bontango/GottFA1_PLuS/docs/GottFA1_PLuS_user_manual.html

# GottFA1_PLuS

Gottlieb System1 MPU based on FPGA

plus: Power, Lamps, Solenoids & Sound

Hardware version v2.x

Software Version x.30

user manual

ralf@lisy.dev

v2.0 24.10.2026

German version: GottFA1_PLuS_Bedienungsanleitung.html. French version: GottFA1_PLuS_manuel_utilisateur.html. The chapter numbering is the same in all three.

## Table of contents

- Important remark
- 1. Introduction
  - 1.1. New in software x.30
- 2. Quickstart
- 3. Installation
- 4. Dip Switch Settings
  - 4.1. S1 game select
  - 4.2. S2 options
    - 4.2.1. S2-Dip1 -> Init nvram
    - 4.2.2. S2-Dip2 -> Freeplay
    - 4.2.3. S2-Dip3 -> LED displays
    - 4.2.4. S2-Dip4 -> Slam
  - 4.3. Integrated soundcard options
  - 4.4. Gottlieb DIP banks
  - 4.5. The buttons
- 5. Boot sequence
  - 5.1. Phase 1: loading the game roms
  - 5.2. Phase 2: info display
  - 5.3. Phase 3: program execution
  - 5.4. The diagnostic counters
- 6. Integrated Soundcard
  - 6.1. Background music
- 7. GottFA1 Attract Mode for System1
  - 7.1. Syntax for configuration file
  - 7.2. Converter tool attractcsv2bin.exe
- 8. Put the GottFA1 image to the SD card
- 9. Programming the FPGA
  - 9.1. Programmer software
  - 9.2. Install the driver for your USB Blaster
  - 9.3. Program your FPGA
  - 9.4. Board variants and release files
- 10. Structure of SD card
  - 10.1. Rom file structure for GottFA1
  - 10.2. Game selection
  - 10.3. Example Charlie's Angels
- 11. Game roms in the FPGA flash
- 12. Resets in the middle of a game
- Appendix A example 'Gamelist'

## Important remark

By using GottFA1 it is possible to damage your pinball machine. As this is a private project with NO commercial interest the author accepts no liability for any damage that may arise by using GottFA1!

## 1. Introduction

GottFA1_PLuS replaces almost all components of your Gottlieb System1 game. This includes:

- Main CPU board
- Power supply
- Driver board
- Soundcard

What do you need?

- Basic soldering skills
- Possibility to read/write micro SD cards (not needed if the game roms are in the FPGA flash, chapter 11)
- A PC with an USB port and an USB Blaster in order to be able to program the FPGA
- Gottlieb rom images (not included due to copyright limitation)

### 1.1. New in software x.30

- Game roms in the FPGA flash. If no SD card answers, GottFA1 reads the game roms from the flash memory the FPGA itself boots from. A board with roms in the flash runs without SD card (chapter 11).
- Reset button filtered. The 'FPGA reset' button has to be pressed for at least 50 ms. Before x.30 a single short spike on its line - typically from a coil without working flyback diode - restarted the board in the middle of a game (chapter 12).
- Slam, outhole and Gottlieb reset switch are filtered against spikes of less than 1 ms.
- Diagnostic counters on the boot display, player 4 (chapter 5.4).
- All five board variants show the same software state: 5.30, 6.30, 7.30, 8.30 and 9.30 (chapter 9.4). 5.30 is new: hardware v2.0x with the Cyclone IV board v3.

## 2. Quickstart

1. Download the latest versions of the SD card image and the FPGA program from lisy.dev - the FPGA program for your FPGA board, see chapter 9.4
2. Write the image to a SD card
3. Add Gottlieb roms
4. Program the FPGA
5. Configure switch 'game select' according to your pinball
6. Replace your original System1 MPU with GottFA1
7. Init the GottFA1 internal nvram for your game
8. Switch the game ON
9. Enjoy

## 3. Installation

GottFA1 boards have the same connectors and same mounting holes as the original Gottlieb System1 MPUs, so replacing the board can be done in seconds.

## 4. Dip Switch Settings

### 4.1. S1 game select

Here you can select what game GottFA1 should run. This depends on the roms placed on the SD card (or in the FPGA flash, chapter 11). See chapter 10 for an explanation of the structure of the SD card content and Appendix A for the arrangement on my SD card image.

### 4.2. S2 options

#### 4.2.1. S2-Dip1 -> Init nvram

With dip1 'ON' GottFA1 will initialize the nvram during boot for the selected game to zero. This is useful if you want to reset ALL ram content (recommended for the first start of the game).

#### 4.2.2. S2-Dip2 -> Freeplay

With dip2 'ON' GottFA1 will enable 'Freeplay'. By 'press and hold' the credit button for more than two seconds a coin insert for the left coin chute is simulated.

#### 4.2.3. S2-Dip3 -> LED displays

With dip3 'ON' the timing for refreshing the displays is optimized for LEDs. With the timing for the original 'tube' displays the LED displays sometimes show flickering, whereas with the 'LED' timing the 'tubes' show 'ghosting'.

#### 4.2.4. S2-Dip4 -> Slam

With dip4 'ON' GottFA1 will disable the Gottlieb slam detection (recommended).

### 4.3. Integrated soundcard options

DIP | Function
Dip1 | Sound or Tones - same as with the original soundcard
Dip2 | Attract sounds - same as with the original soundcard
Dip3 | Background music with the integrated MP3 player (chapter 6.1)

### 4.4. Gottlieb DIP banks

Here you have the same settings as with an original MPU. Consult the manual for your pinball to see how they affect the game behavior. For a 'smooth start' I recommend the following settings:

S1...S8: all OFF · S9...S16: all ON · S17...S24: DIP19 OFF, all other ON

Note: DIP16 & DIP24 are not used on the original CPU. With GottFA1 DIP16 is an option for background music (chapter 6.1) and with DIP24 you can enable attract mode (chapter 7).

### 4.5. The buttons

Button | Function
FPGA reset | Restarts GottFA1: the game roms are read again, the boot sequence starts from the beginning. Since x.30 it has to be pressed for at least 50 ms - a short tap does nothing, and neither does a spike on its line (chapter 12).
GTB_Reset | The reset switch of the original Gottlieb MPU, read by the game program.
Test | The Gottlieb test switch.
SB Test | Sound test of the integrated soundcard, as with the original Multisound board.

## 5. Boot sequence

### 5.1. Phase 1: loading the game roms

Immediately after switching on the pinball with GottFA1 inserted you will see the following output on the displays of your pinball machine:

Display | Content
Player 1 | GOTTFA
Player 2 and 3 | welcome message BY BON TANGO
Player 4 | the diagnostic counters, for example R00G00 (chapter 5.4)
Status display | setting of the soundcard options and current setting (decimal) of S1 (game number)

Meanwhile GottFA1 reads the game roms from the SD card. If no SD card answers, it reads them from the FPGA flash instead (chapter 11). With a card in the slot the card always wins.

If neither works the red LED 'SD card error' goes ON, player 4 shows ERROR, and the game does not start. With the FPGA program from lisy.dev the flash holds no roms, so without SD card that is what you will see.

### 5.2. Phase 2: info display

As soon as the roms are loaded:

Display | Content
Player 1 | GOTTFA
Player 2 | version of the FPGA program running, for example V 930 (chapter 9.4)
Player 3 | READSD - the roms came from the SD card, or READFL - the roms came from the FPGA flash
Player 4 | the diagnostic counters, or ERROR
Status display | as in phase 1

### 5.3. Phase 3: program execution

The code indicated by the Dip switch 'game select' is executed. If the code runs (regular interrupts are seen) the 'active' LED will go ON and the game takes over the displays.

### 5.4. The diagnostic counters

New with x.30. Player 4 shows two counters during boot, for example R01G37:

- R - resets that came through the 'FPGA reset' button (button pressed for at least 50 ms).
- G - short pulses on the reset line that GottFA1 ignored because they were too short to be a button press.

Both counters are only cleared when the FPGA is loaded - at power on, or when it reloads itself. A reset through the button does not clear them. They stop at 99.

So if the game restarted by itself, look at player 4 while it boots:

Player 4 after an unexpected restart | Meaning
R00G00 | The FPGA was loaded again: the supply voltage dropped, or a spike reached the configuration of the FPGA. See chapter 12.
R counted up | The reset line was low for at least 50 ms: the button was pressed, or a very strong disturbance.
G above 0 | Spikes reach the reset line and were filtered. A normal press of the button also adds a few, because the button bounces.

## 6. Integrated Soundcard

GottFA1_PLuS comes with an integrated soundcard emulation. You can choose whether you want to keep your original soundcard or use the integrated one. In case you want to use the integrated one, you need to add two wires from the GottFA speaker connector to the speaker in the cabinet.

GottFA1_PLuS can emulate the sounds of games with the Gottlieb Multisound card (games Totem and later) but as well games with the '3 tone chime board'. You can even use the 3 tone emulation for games which do have a chime board by adding a speaker to your game.

SB option switches DIP1 & 2 and the 'SB test' button have the same functionality as with the original Multisound board. With Dip1 you can choose between 'Sound' and 'Tones'. Dip2 activates attract sound (Gottlieb issues attract sounds every 8 minutes or so).

### 6.1. Background music

Dip3 of the SB options activates background music via the MP3 player. You can use a standard SD card (up to 32 GByte) and put mp3 and/or wav files of your choice on it.

Create a folder '02' (zero two) on the SD card and put all your music files in there.

GottFA1 will play the files randomly during gameplay.

With DIP16 of the Gottlieb DIP bank you can select whether the music files are started from the beginning each time you start a new game (DIP16 ON) or whether GottFA1 should remember the point in time where the music has stopped and continue at this point with the next game (DIP16 OFF).

## 7. GottFA1 Attract Mode for System1

GottFA1 supports attract mode for System1. Attract mode is activated/deactivated with Gottlieb DIP switch #24.

The attract mode actions can be self-defined in a csv configuration file which has to be converted, and the resulting '.bin' file has to be integrated in the rom on the SD card (see the example in chapter 10.3).

I have created a basic set of configuration files which can be downloaded from my repository server. Links can be found on my website https://www.lisy.dev. My SD card image already contains them for all 16 games.

### 7.1. Syntax for configuration file

During attract mode the csv file will be scanned and the commands in there will be executed. If the scan reaches the end of the configuration file it will start at the beginning again. The syntax for GottFA1 is compatible with the LISY1 syntax, with the limitation that only the commands 'lamp' and 'time' are supported.

time <wait time> <s | ms>

Wait 'wait time' in seconds or milliseconds before executing the next command. Only integer values are supported!

lamp <lamp number> <on | off>

Switch the lamp 'lamp number' (1..36) ON or OFF.

### 7.2. Converter tool attractcsv2bin.exe

You find the tool on my repository server (windows executable). It converts a csv file with attract mode commands to a bin file (fixed size 4 KByte) which can be integrated into the rom on the SD card.

Example converting 005_attract.csv to 005_attract.bin:

attractcsv2bin 005_attract

opening input file: 005_attract.csv
creating output file: 005_attract.bin
csv contained 34 commands
22 lamp commands written
12 time commands written
wrote 121 of possible 4096 bytes

## 8. Put the GottFA1 image to the SD card

On my website you will find the latest version of the GottFA1 SD card image as a (zipped) image file. After unpacking, the image can be put on a SD card. I recommend using Win32DiskImager for doing that.

This chapter uses content from the eLinux wiki page RPi_Easy_SD_Card_Setup (http://elinux.org/RPi_Easy_SD_Card_Setup), which is shared under the Creative Commons Attribution-ShareAlike 3.0 Unported license (http://creativecommons.org/licenses/by-sa/3.0/)

- Insert the SD card into your SD card reader. You can use the SD card slot if you have one, or an SD adapter in a USB port. Note the drive letter assigned to the SD card. You can see the drive letter in the left hand column of Windows Explorer, for example E:
- Download the Win32DiskImager utility from the Sourceforge Project page (http://sourceforge.net/projects/win32diskimager/) as an installer file, and run it to install the software.
- Run the Win32DiskImager utility from your desktop or menu.
- Select the GottFA1 image file you extracted earlier.
- In the device box, select the drive letter of the SD card. Be careful to select the correct drive: if you choose the wrong drive you could destroy the data on your computer's hard disk! If you are using an SD card slot in your computer, and can't see the drive in the Win32DiskImager window, try using an external SD adapter.
- Click 'Write' and wait for the write to complete.
- Exit the imager and eject the SD card.

## 9. Programming the FPGA

To program the FPGA you need the Quartus Programmer and an USB Blaster.

### 9.1. Programmer software

It can be downloaded from the Intel website for free, you just need to create a user account. In the download section of Quartus Prime Lite Edition (version 22.1 or later) go to 'Additional Software' and download Quartus Prime Programmer and Tools.

The FPGA boards of GottFA1_PLuS use a Cyclone IV or a Cyclone 10 LP. The old Quartus II 13.0sp1 does not know the Cyclone 10 LP; use a current programmer.

### 9.2. Install the driver for your USB Blaster

When connecting your USB Blaster the first time it will not be recognized correctly by Windows.

You need to install the driver for your USB Blaster. The driver comes together with the installation of the programmer and is located in its 'drivers' subdirectory.

- Right click on the entry in the device manager and choose 'update driver' (Treiber aktualisieren)
- Choose 'search for driver on this PC' (auf dem Computer nach Treibersoftware suchen)
- Select the 'drivers' folder of your programmer installation
- Confirm installation
- Now the Altera USB Blaster should be visible under 'USB-Controller'

### 9.3. Program your FPGA

1. Connect the USB Blaster to the PC

2. Start the programmer, make sure in the Hardware setup 'USB-Blaster' is visible and set the Mode to 'JTAG'

3. Select 'Add File' and choose the right 'jic' file for your FPGA board (chapter 9.4). Select the 'Program/Configure' and 'Verify' options.

4. Power the board, then connect the USB Blaster to the 'JTAG programming' connector on the GottFA1_PLuS board. Push start and wait for progress 100%. That's it!

The screenshots show an older version of the programmer; the current one looks almost the same.

### 9.4. Board variants and release files

The same design runs on several FPGA boards, and the FPGA program is not interchangeable between them - the pin assignment differs. The first digit of the version shown on player display 2 at boot tells you which program is running.

Version | Board | FPGA | Release file x.30
9.30 | HW v2.1x with Cyclone 10 board | 10CL006YE144 | HW21x_Cyclone10/GottFA1_PLuS_v930.jic
8.30 | HW v2.1x with Cyclone IV board v4 | EP4CE6E22 | HW21x_CycloneIV_v4/GottFA1_PLuS_v830.jic
7.30 | HW v2.0x with Cyclone IV board v4 | EP4CE6E22 | HW20x_CycloneIV_v4/GottFA1_PLuS_v730.jic
6.30 | HW v2.1x with Cyclone IV board v3 | EP4CE6F17 | HW21x_CycloneIV_v3/GottFA1_PLuS_v630.jic
5.30 | HW v2.0x with Cyclone IV board v3 | EP4CE6F17 | HW20x_CycloneIV_v3/GottFA1_PLuS_v530.jic

The release files have no game roms in the flash. How to build a file with roms is described in chapter 11.

Test status: 7.30 and 5.30 (both HW v2.0x) have been tested successfully on real boards. 9.30, 8.30 and 6.30 have not been tested in hardware yet; the last versions that ran on those boards are 9.01 and 8.01, a version 6.xx has never been delivered.

## 10. Structure of SD card

Due to limitations of the SD card read routine in the FPGA (it reads fixed sector numbers instead of looking for filenames) it is necessary to use my SD card image (128 MByte). You can write the image to a SD card of your choice, any size equal to or bigger than 128 MByte will work.

Note: 'Sandisk' SD cards can not be used with GottFA1!

### 10.1. Rom file structure for GottFA1

For each game GottFA1 reads a 16 KByte block from the SD card. Every block starts at sector 660 + game number x 32 and has this layout:

Offset | Size | Content
0x0000 | 2 KByte | system rom 'u5_cf.bin'
0x0800 | 2 KByte | system rom 'u4_ce.bin'
0x1000 | 1 KByte | the game specific rom, e.g. '425.cpu'
0x1400 | 1 KByte | sound rom of the Multisound games, e.g. '429.snd' - otherwise empty
0x1800 | 1 KByte | '6530sys1.bin' for the Multisound games - otherwise empty
0x1C00 | 5 KByte | gap, not used
0x3000 | 4 KByte | attract mode commands, e.g. '005_attract.bin' (chapter 7)

The gaps have to be filled, so that every block has exactly 16 KByte. There is no checksum.

### 10.2. Game selection

The first image you copy onto the SD card will be selected with game select '0' (all OFF), the second with '1' (all OFF except Dip1) and so on.

As the FPGA just reads fixed sector numbers the filename is not relevant, you can choose whatever filename you want. It just needs to be placed at the right position on the SD card. You can 'select' the position of the rom image on the SD card with the order of your file copy.

### 10.3. Example Charlie's Angels

For Charlie's Angels you need (as for all other System1 games) the two system roms 'u5_cf.bin' and 'u4_ce.bin' and the game specific rom, '425.cpu' in this case. To create a rom file for GottFA1 (charlies) including the attract mode commands you can use the following command on a windows system:

copy /b u5_cf.bin + u4_ce.bin + 425.cpu + 7K + 005_attract.bin charlies

For a Multisound game the sound roms come in between, e.g. for Totem:

copy /b u5_cf.bin + u4_ce.bin + 429.cpu + 429.snd + 6530sys1.bin + 5K + 009_attract.bin totem

The files '5K' and '7K' do not contain any data and just exist to fill the gap. They can be downloaded from my software repository on lisy.dev.

## 11. Game roms in the FPGA flash

New with software x.30. The FPGA boots from a flash chip (EPCS16, 2 MByte) on the FPGA board, and the space behind the FPGA program can hold the game roms of all 16 games. A board with roms in the flash runs without SD card.

flash address 080000h + game number x 4000h, 16 KByte per game - exactly the block of the SD card (chapter 10.1)
- With a card in the slot the card always wins. So you can still try other roms from a card without touching the flash.
- If the card is missing or does not answer, the board reads the flash. Player 3 then shows READFL instead of READSD (chapter 5.2).
- There is no checksum, neither on the card nor in the flash. GottFA1 only checks that the slot of the selected game is not empty; an empty slot shows ERROR.

The roms are copyrighted, so they cannot be part of the download from lisy.dev. You put them there yourself, from your own SD card image:

1. Build the rom file. In the GottFA1_PLuS source tree (github.com/bontango/GottFA1_PLuS) run

 scripts\make_flash_hex.ps1 -Image <image file> -Out variants\<variant>\output_files\gottfa1_roms.hex
  The script lists every game it found. Games 0 to 15 are taken, empty slots are left out.
2. Build the FPGA program of your board in the folder variants\<variant> (or take the SYS1.sof of a build) and run quartus_cpf -c gottfa1_roms.cof there. This puts the FPGA program and the roms into one file, output_files\gottfa1_roms.jic.
3. Program gottfa1_roms.jic with the Quartus Programmer instead of the normal file, with 'Verify' ticked (chapter 9.3).

The variant names are those of the source tree: hw21x_cyclone_10, hw21x_cyclone_iv_v4, hw20x_cyclone_iv_v4, hw21x_cyclone_iv_v3, hw20x_cyclone_iv_v3.

Keep that file to yourself. It contains the game roms and must not be passed on.

## 12. Resets in the middle of a game

If your game restarts by itself during play, the reason is almost always a coil whose flyback diode is missing or broken. When such a coil is switched off, it sends a voltage spike through the wiring of the machine, and this spike can reach the electronics of GottFA1.

1. Check the flyback diodes of all coils and relays (Gottlieb puts a 1N4004 directly on each coil). This is the real fix.
2. Use software x.30 or later. Up to x.03 a single spike of a few nanoseconds on the line of the 'FPGA reset' button was enough to restart the board. Since x.30 that line has to be low for 50 ms.
3. Look at the diagnostic counters after a restart (chapter 5.4). R00G00 means the FPGA was loaded again - then check the supply voltages and the coils firing at that moment.
4. On older boards a 100 nF capacitor soldered in parallel to the 'FPGA reset' button additionally keeps spikes away from that line.

The full analysis (in German) with recommendations for the hardware is in the source tree: docs/Stoerimpulse_Resets.md (https://github.com/bontango/GottFA1_PLuS/blob/main/docs/Stoerimpulse_Resets.md).

## Appendix A example 'Gamelist'

This is the arrangement on my SD card image (v2.00). Games 0 to 8 use the 3 tone sound, games 9 to 15 the Multisound board.

No | S1 | S2 | S3 | S4 | Short Name | Long Name
0 | off | off | off | off | cleoptra | Cleopatra
1 | on | off | off | off | sinbad | Sinbad
2 | off | on | off | off | jokrpokr | Joker Poker
3 | on | on | off | off | dragon | Dragon
4 | off | off | on | off | closeenc | Close Encounters of the Third Kind
5 | on | off | on | off | charlies | Charlie's Angels
6 | off | on | on | off | solaride | Solar Ride
7 | on | on | on | off | countdwn | Count-Down
8 | off | off | off | on | pinpool | Pinball Pool
9 | on | off | off | on | totem | Totem
10 | off | on | off | on | hulk | The Incredible Hulk
11 | on | on | off | on | genie | Genie
12 | off | off | on | on | buckrgrs | Buck Rogers
13 | on | off | on | on | torch | Torch
14 | off | on | on | on | roldisco | Roller Disco
15 | on | on | on | on | astannie | Asteroid Annie and the Aliens
