bontango/GottFA1_PLuS/docs/GottFA1_PLuS_Bedienungsanleitung.html

# GottFA1_PLuS

Gottlieb-System1-MPU auf FPGA-Basis

plus: Netzteil, Lampen, Spulen & Sound

Hardware-Version v2.x

Software-Version x.30

Bedienungsanleitung

ralf@lisy.dev

v2.0 24.10.2026

Deutsche Fassung von GottFA1_PLuS_user_manual.html. Version française : GottFA1_PLuS_manuel_utilisateur.html. Die Kapitelnummern sind in allen drei Fassungen gleich.

## Inhaltsverzeichnis

- Wichtiger Hinweis
- 1. Einleitung
  - 1.1. Neu in Software x.30
- 2. Schnellstart
- 3. Einbau
- 4. DIP-Schalter
  - 4.1. S1 Spielauswahl
  - 4.2. S2 Optionen
    - 4.2.1. S2-Dip1 -> NVRAM initialisieren
    - 4.2.2. S2-Dip2 -> Freispiel
    - 4.2.3. S2-Dip3 -> LED-Anzeigen
    - 4.2.4. S2-Dip4 -> Slam
  - 4.3. Optionen der integrierten Soundkarte
  - 4.4. Gottlieb-DIP-Bänke
  - 4.5. Die Taster
- 5. Startvorgang
  - 5.1. Phase 1: die Spiel-ROMs laden
  - 5.2. Phase 2: Info-Anzeige
  - 5.3. Phase 3: Programmausführung
  - 5.4. Die Diagnosezähler
- 6. Integrierte Soundkarte
  - 6.1. Hintergrundmusik
- 7. GottFA1-Attract-Mode für System1
  - 7.1. Syntax der Konfigurationsdatei
  - 7.2. Konverter attractcsv2bin.exe
- 8. Das GottFA1-Image auf die SD-Karte schreiben
- 9. Das FPGA programmieren
  - 9.1. Programmer-Software
  - 9.2. Treiber für den USB Blaster installieren
  - 9.3. Das FPGA programmieren
  - 9.4. Platinenvarianten und Release-Dateien
- 10. Aufbau der SD-Karte
  - 10.1. Aufbau einer ROM-Datei für GottFA1
  - 10.2. Spielauswahl
  - 10.3. Beispiel Charlie's Angels
- 11. Spiel-ROMs im FPGA-Flash
- 12. Resets mitten im Spiel
- Anhang A Beispiel 'Spieleliste'

## Wichtiger Hinweis

Mit GottFA1 kann man seinen Flipper beschädigen. Da es sich um ein privates Projekt OHNE kommerzielles Interesse handelt, übernimmt der Autor keinerlei Haftung für Schäden, die durch den Einsatz von GottFA1 entstehen!

## 1. Einleitung

GottFA1_PLuS ersetzt fast alle Baugruppen Ihres Gottlieb-System1-Geräts, nämlich:

- die CPU-Platine (MPU)
- das Netzteil
- die Treiberplatine
- die Soundkarte

Was Sie brauchen:

- Grundkenntnisse im Löten
- eine Möglichkeit, Micro-SD-Karten zu lesen und zu schreiben (entfällt, wenn die Spiel-ROMs im FPGA-Flash liegen, Kapitel 11)
- einen PC mit USB-Anschluss und einen USB Blaster, um das FPGA zu programmieren
- Gottlieb-ROM-Images (aus Urheberrechtsgründen nicht enthalten)

### 1.1. Neu in Software x.30

- Spiel-ROMs im FPGA-Flash. Antwortet keine SD-Karte, liest GottFA1 die Spiel-ROMs aus dem Flash-Speicher, aus dem das FPGA selbst startet. Eine Platine mit ROMs im Flash läuft ohne SD-Karte (Kapitel 11).
- Reset-Taster gefiltert. Der Taster 'FPGA reset' muss mindestens 50 ms gedrückt sein. Vor x.30 reichte ein einziger kurzer Störimpuls auf seiner Leitung - typischerweise von einer Spule ohne funktionierende Freilaufdiode -, um die Platine mitten im Spiel neu zu starten (Kapitel 12).
- Slam, Outhole und Gottlieb-Reset-Schalter sind gegen Störimpulse unter 1 ms gefiltert.
- Diagnosezähler auf der Startanzeige, Spieler 4 (Kapitel 5.4).
- Alle fünf Platinenvarianten haben denselben Softwarestand: 5.30, 6.30, 7.30, 8.30 und 9.30 (Kapitel 9.4). Neu ist 5.30: Hardware v2.0x mit der Cyclone-IV-Platine v3.

## 2. Schnellstart

1. Die aktuellen Versionen des SD-Karten-Images und des FPGA-Programms von lisy.dev herunterladen - das FPGA-Programm für Ihre FPGA-Platine, siehe Kapitel 9.4
2. Das Image auf eine SD-Karte schreiben
3. Die Gottlieb-ROMs hinzufügen
4. Das FPGA programmieren
5. Den Schalter 'Spielauswahl' passend zu Ihrem Flipper einstellen
6. Die originale System1-MPU durch GottFA1 ersetzen
7. Das interne NVRAM von GottFA1 für Ihr Spiel initialisieren
8. Den Flipper einschalten
9. Spielen

## 3. Einbau

GottFA1-Platinen haben dieselben Steckverbinder und dieselben Befestigungslöcher wie die originalen Gottlieb-System1-MPUs. Der Tausch ist in Sekunden erledigt.

## 4. DIP-Schalter

### 4.1. S1 Spielauswahl

Hier wählen Sie, welches Spiel GottFA1 ausführt. Das hängt davon ab, welche ROMs auf der SD-Karte (oder im FPGA-Flash, Kapitel 11) liegen. Kapitel 10 erklärt den Aufbau der SD-Karte, Anhang A zeigt die Belegung meines SD-Karten-Images.

### 4.2. S2 Optionen

#### 4.2.1. S2-Dip1 -> NVRAM initialisieren

Mit Dip1 auf 'ON' setzt GottFA1 beim Start das NVRAM des gewählten Spiels auf null. Das ist nützlich, wenn Sie den GESAMTEN RAM-Inhalt zurücksetzen wollen (empfohlen beim ersten Start des Spiels).

#### 4.2.2. S2-Dip2 -> Freispiel

Mit Dip2 auf 'ON' schaltet GottFA1 das Freispiel ein. Wird der Credit-Knopf länger als zwei Sekunden gedrückt gehalten, simuliert GottFA1 einen Münzeinwurf im linken Münzprüfer.

#### 4.2.3. S2-Dip3 -> LED-Anzeigen

Mit Dip3 auf 'ON' ist das Timing für die Auffrischung der Anzeigen auf LEDs optimiert. Mit dem Timing für die originalen Röhrenanzeigen flackern LED-Anzeigen manchmal, mit dem LED-Timing zeigen die Röhren dagegen 'Geisterbilder'.

#### 4.2.4. S2-Dip4 -> Slam

Mit Dip4 auf 'ON' schaltet GottFA1 die Slam-Erkennung von Gottlieb ab (empfohlen).

### 4.3. Optionen der integrierten Soundkarte

DIP | Funktion
Dip1 | Sound oder Töne - wie bei der originalen Soundkarte
Dip2 | Attract-Sounds - wie bei der originalen Soundkarte
Dip3 | Hintergrundmusik über den integrierten MP3-Player (Kapitel 6.1)

### 4.4. Gottlieb-DIP-Bänke

Hier haben Sie dieselben Einstellungen wie bei einer originalen MPU. Wie sie sich auf das Spiel auswirken, steht im Handbuch Ihres Flippers. Für einen 'sanften Start' empfehle ich:

S1...S8: alle OFF · S9...S16: alle ON · S17...S24: DIP19 OFF, alle anderen ON

Hinweis: DIP16 und DIP24 werden auf der originalen CPU nicht benutzt. Bei GottFA1 ist DIP16 eine Option für die Hintergrundmusik (Kapitel 6.1), mit DIP24 schalten Sie den Attract-Mode ein (Kapitel 7).

### 4.5. Die Taster

Taster | Funktion
FPGA reset | Startet GottFA1 neu: die Spiel-ROMs werden neu gelesen, der Startvorgang beginnt von vorn. Seit x.30 muss er mindestens 50 ms gedrückt sein - kurzes Antippen bewirkt nichts, ein Störimpuls auf seiner Leitung ebenso wenig (Kapitel 12).
GTB_Reset | Der Reset-Schalter der originalen Gottlieb-MPU, wird vom Spielprogramm gelesen.
Test | Der Gottlieb-Testschalter.
SB Test | Soundtest der integrierten Soundkarte, wie bei der originalen Multisound-Karte.

## 5. Startvorgang

### 5.1. Phase 1: die Spiel-ROMs laden

Direkt nach dem Einschalten des Flippers mit eingesetztem GottFA1 sehen Sie auf den Anzeigen:

Anzeige | Inhalt
Spieler 1 | GOTTFA
Spieler 2 und 3 | Begrüßung BY BON TANGO
Spieler 4 | die Diagnosezähler, zum Beispiel R00G00 (Kapitel 5.4)
Statusanzeige | Einstellung der Soundkarten-Optionen und aktuelle Einstellung (dezimal) von S1 (Spielnummer)

Währenddessen liest GottFA1 die Spiel-ROMs von der SD-Karte. Antwortet keine SD-Karte, liest es sie stattdessen aus dem FPGA-Flash (Kapitel 11). Steckt eine Karte, hat die Karte immer Vorrang.

Klappt beides nicht, geht die rote LED 'SD card error' an, Spieler 4 zeigt ERROR, und das Spiel startet nicht. Mit dem FPGA-Programm von lisy.dev enthält der Flash keine ROMs - ohne SD-Karte sehen Sie also genau das.

### 5.2. Phase 2: Info-Anzeige

Sobald die ROMs geladen sind:

Anzeige | Inhalt
Spieler 1 | GOTTFA
Spieler 2 | Version des laufenden FPGA-Programms, zum Beispiel V 930 (Kapitel 9.4)
Spieler 3 | READSD - die ROMs kamen von der SD-Karte, oder READFL - die ROMs kamen aus dem FPGA-Flash
Spieler 4 | die Diagnosezähler oder ERROR
Statusanzeige | wie in Phase 1

### 5.3. Phase 3: Programmausführung

Der mit dem DIP-Schalter 'Spielauswahl' gewählte Code wird ausgeführt. Läuft der Code (regelmäßige Interrupts), geht die LED 'active' an und das Spiel übernimmt die Anzeigen.

### 5.4. Die Diagnosezähler

Neu mit x.30. Spieler 4 zeigt beim Start zwei Zähler, zum Beispiel R01G37:

- R - Resets, die über den Taster 'FPGA reset' kamen (Taster mindestens 50 ms gedrückt).
- G - kurze Impulse auf der Reset-Leitung, die GottFA1 ignoriert hat, weil sie für einen Tastendruck zu kurz waren.

Beide Zähler werden nur gelöscht, wenn das FPGA geladen wird - beim Einschalten oder wenn es sich selbst neu lädt. Ein Reset über den Taster löscht sie nicht. Sie bleiben bei 99 stehen.

Ist das Spiel also von selbst neu gestartet, schauen Sie beim Start auf Spieler 4:

Spieler 4 nach einem unerwarteten Neustart | Bedeutung
R00G00 | Das FPGA wurde neu geladen: die Versorgungsspannung ist eingebrochen, oder ein Störimpuls hat die Konfiguration des FPGA erreicht. Siehe Kapitel 12.
R hochgezählt | Die Reset-Leitung war mindestens 50 ms low: der Taster wurde gedrückt, oder eine sehr starke Störung.
G über 0 | Störimpulse erreichen die Reset-Leitung und wurden ausgefiltert. Auch ein normaler Tastendruck zählt ein paar dazu, weil der Taster prellt.

## 6. Integrierte Soundkarte

GottFA1_PLuS hat eine integrierte Soundkarten-Emulation. Sie können Ihre originale Soundkarte behalten oder die integrierte benutzen. Für die integrierte brauchen Sie zwei Leitungen vom Lautsprecheranschluss der GottFA-Platine zum Lautsprecher im Gehäuse.

GottFA1_PLuS emuliert die Sounds der Spiele mit der Gottlieb-Multisound-Karte (Totem und später), aber auch die der Spiele mit der '3-Ton-Glockenplatine'. Die 3-Ton-Emulation können Sie sogar bei Spielen mit Glockenplatine verwenden, wenn Sie einen Lautsprecher einbauen.

Die SB-Optionsschalter DIP1 und 2 und der Taster 'SB test' funktionieren wie auf der originalen Multisound-Karte. Mit Dip1 wählen Sie zwischen 'Sound' und 'Tönen'. Dip2 schaltet die Attract-Sounds ein (Gottlieb spielt etwa alle 8 Minuten einen Attract-Sound).

### 6.1. Hintergrundmusik

Dip3 der SB-Optionen schaltet die Hintergrundmusik über den MP3-Player ein. Sie können eine normale SD-Karte (bis 32 GByte) verwenden und mp3- und/oder wav-Dateien Ihrer Wahl darauf ablegen.

Legen Sie auf der SD-Karte einen Ordner '02' (null zwei) an und kopieren Sie alle Musikdateien dort hinein.

GottFA1 spielt die Dateien während des Spiels in zufälliger Reihenfolge.

Mit DIP16 der Gottlieb-DIP-Bank wählen Sie, ob die Musik bei jedem neuen Spiel von vorn beginnt (DIP16 ON) oder ob GottFA1 sich die Stelle merkt, an der die Musik aufgehört hat, und im nächsten Spiel dort weiterspielt (DIP16 OFF).

## 7. GottFA1-Attract-Mode für System1

GottFA1 unterstützt einen Attract-Mode für System1. Der Attract-Mode wird mit dem Gottlieb-DIP-Schalter #24 ein- und ausgeschaltet.

Die Abläufe des Attract-Mode lassen sich selbst in einer csv-Konfigurationsdatei festlegen. Diese wird umgewandelt, und die entstehende '.bin'-Datei wird in das ROM auf der SD-Karte eingebaut (siehe Beispiel in Kapitel 10.3).

Einen Grundstock an Konfigurationsdateien gibt es auf meinem Repository-Server, die Links stehen auf meiner Website https://www.lisy.dev. Mein SD-Karten-Image enthält sie bereits für alle 16 Spiele.

### 7.1. Syntax der Konfigurationsdatei

Im Attract-Mode wird die csv-Datei durchlaufen und die Befehle darin werden ausgeführt. Am Ende der Datei beginnt der Durchlauf wieder von vorn. Die Syntax ist zu LISY1 kompatibel, mit der Einschränkung, dass nur die Befehle 'lamp' und 'time' unterstützt werden.

time <wait time> <s | ms>

Wartet 'wait time' Sekunden oder Millisekunden, bevor der nächste Befehl ausgeführt wird. Nur ganze Zahlen!

lamp <lamp number> <on | off>

Schaltet die Lampe 'lamp number' (1..36) ein (ON) oder aus (OFF).

### 7.2. Konverter attractcsv2bin.exe

Das Programm (Windows) finden Sie auf meinem Repository-Server. Es wandelt eine csv-Datei mit Attract-Mode-Befehlen in eine bin-Datei (feste Größe 4 KByte) um, die in das ROM auf der SD-Karte eingebaut werden kann.

Beispiel: 005_attract.csv in 005_attract.bin umwandeln:

attractcsv2bin 005_attract

opening input file: 005_attract.csv
creating output file: 005_attract.bin
csv contained 34 commands
22 lamp commands written
12 time commands written
wrote 121 of possible 4096 bytes

## 8. Das GottFA1-Image auf die SD-Karte schreiben

Auf meiner Website finden Sie die aktuelle Version des GottFA1-SD-Karten-Images als (gezippte) Image-Datei. Nach dem Entpacken kann das Image auf eine SD-Karte geschrieben werden. Ich empfehle dafür Win32DiskImager.

Dieses Kapitel verwendet Inhalte der eLinux-Wiki-Seite RPi_Easy_SD_Card_Setup (http://elinux.org/RPi_Easy_SD_Card_Setup), veröffentlicht unter der Creative Commons Attribution-ShareAlike 3.0 Unported license (http://creativecommons.org/licenses/by-sa/3.0/)

- Stecken Sie die SD-Karte in Ihr Kartenlesegerät - den eingebauten Kartenschlitz, falls vorhanden, oder einen SD-Adapter am USB-Anschluss. Merken Sie sich den Laufwerksbuchstaben der SD-Karte. Sie sehen ihn in der linken Spalte des Windows-Explorers, zum Beispiel E:
- Laden Sie Win32DiskImager als Installationsdatei von der Sourceforge-Projektseite (http://sourceforge.net/projects/win32diskimager/) herunter und installieren Sie das Programm.
- Starten Sie Win32DiskImager über den Desktop oder das Startmenü.
- Wählen Sie die zuvor entpackte GottFA1-Image-Datei aus.
- Wählen Sie im Feld 'Device' den Laufwerksbuchstaben der SD-Karte. Achten Sie auf das richtige Laufwerk: wählen Sie ein falsches, können Sie die Daten auf der Festplatte Ihres Computers zerstören! Sehen Sie bei einem eingebauten Kartenschlitz das Laufwerk im Fenster von Win32DiskImager nicht, versuchen Sie es mit einem externen SD-Adapter.
- Klicken Sie auf 'Write' und warten Sie, bis der Schreibvorgang abgeschlossen ist.
- Beenden Sie das Programm und werfen Sie die SD-Karte aus.

## 9. Das FPGA programmieren

Zum Programmieren des FPGA brauchen Sie den Quartus Programmer und einen USB Blaster.

### 9.1. Programmer-Software

Sie können ihn kostenlos von der Intel-Website herunterladen, Sie brauchen nur ein Benutzerkonto. Im Download-Bereich der Quartus Prime Lite Edition (Version 22.1 oder neuer) unter 'Additional Software' laden Sie Quartus Prime Programmer and Tools herunter.

Die FPGA-Platinen von GottFA1_PLuS tragen einen Cyclone IV oder einen Cyclone 10 LP. Das alte Quartus II 13.0sp1 kennt den Cyclone 10 LP nicht; verwenden Sie einen aktuellen Programmer.

### 9.2. Treiber für den USB Blaster installieren

Wenn Sie den USB Blaster zum ersten Mal anschließen, erkennt Windows ihn nicht richtig.

Sie müssen den Treiber für den USB Blaster installieren. Er wird zusammen mit dem Programmer installiert und liegt dort im Unterordner 'drivers'.

- Rechtsklick auf den Eintrag im Geräte-Manager, 'Treiber aktualisieren' wählen
- 'Auf dem Computer nach Treibersoftware suchen' wählen
- Den Ordner 'drivers' Ihrer Programmer-Installation auswählen
- Installation bestätigen
- Jetzt sollte der Altera USB Blaster unter 'USB-Controller' zu sehen sein

### 9.3. Das FPGA programmieren

1. Den USB Blaster mit dem PC verbinden

2. Den Programmer starten, unter 'Hardware Setup' prüfen, dass 'USB-Blaster' zu sehen ist, und den Modus auf 'JTAG' stellen

3. 'Add File' wählen und die richtige 'jic'-Datei für Ihre FPGA-Platine auswählen (Kapitel 9.4). Die Optionen 'Program/Configure' und 'Verify' ankreuzen.

4. Die Platine mit Strom versorgen und den USB Blaster an den Stecker 'JTAG programming' auf der GottFA1_PLuS-Platine anschließen. 'Start' drücken und warten, bis der Fortschritt 100 % erreicht. Fertig!

Die Bildschirmfotos zeigen eine ältere Version des Programmers; die aktuelle sieht fast genauso aus.

### 9.4. Platinenvarianten und Release-Dateien

Dasselbe Design läuft auf mehreren FPGA-Platinen, und das FPGA-Programm ist zwischen ihnen nicht austauschbar - die Pinbelegung ist verschieden. An der ersten Ziffer der Version, die beim Start auf Spieler 2 erscheint, erkennen Sie, welches Programm läuft.

Version | Platine | FPGA | Release-Datei x.30
9.30 | HW v2.1x mit Cyclone-10-Platine | 10CL006YE144 | HW21x_Cyclone10/GottFA1_PLuS_v930.jic
8.30 | HW v2.1x mit Cyclone-IV-Platine v4 | EP4CE6E22 | HW21x_CycloneIV_v4/GottFA1_PLuS_v830.jic
7.30 | HW v2.0x mit Cyclone-IV-Platine v4 | EP4CE6E22 | HW20x_CycloneIV_v4/GottFA1_PLuS_v730.jic
6.30 | HW v2.1x mit Cyclone-IV-Platine v3 | EP4CE6F17 | HW21x_CycloneIV_v3/GottFA1_PLuS_v630.jic
5.30 | HW v2.0x mit Cyclone-IV-Platine v3 | EP4CE6F17 | HW20x_CycloneIV_v3/GottFA1_PLuS_v530.jic

Die Release-Dateien enthalten keine Spiel-ROMs im Flash. Wie Sie eine Datei mit ROMs bauen, beschreibt Kapitel 11.

Teststand: 7.30 und 5.30 (beide HW v2.0x) sind auf echten Platinen erfolgreich getestet. 9.30, 8.30 und 6.30 sind noch nicht in Hardware getestet; zuletzt liefen auf diesen Platinen 9.01 und 8.01, eine Version 6.xx wurde nie ausgeliefert.

## 10. Aufbau der SD-Karte

Weil die Leseroutine für die SD-Karte im FPGA feste Sektornummern liest, statt nach Dateinamen zu suchen, brauchen Sie mein SD-Karten-Image (128 MByte). Sie können es auf eine beliebige SD-Karte mit mindestens 128 MByte schreiben.

Hinweis: SD-Karten von 'Sandisk' funktionieren mit GottFA1 nicht!

### 10.1. Aufbau einer ROM-Datei für GottFA1

Für jedes Spiel liest GottFA1 einen Block von 16 KByte von der SD-Karte. Jeder Block beginnt bei Sektor 660 + Spielnummer x 32 und ist so aufgebaut:

Offset | Größe | Inhalt
0x0000 | 2 KByte | System-ROM 'u5_cf.bin'
0x0800 | 2 KByte | System-ROM 'u4_ce.bin'
0x1000 | 1 KByte | das spielspezifische ROM, z. B. '425.cpu'
0x1400 | 1 KByte | Sound-ROM der Multisound-Spiele, z. B. '429.snd' - sonst leer
0x1800 | 1 KByte | '6530sys1.bin' für die Multisound-Spiele - sonst leer
0x1C00 | 5 KByte | Lücke, nicht benutzt
0x3000 | 4 KByte | Attract-Mode-Befehle, z. B. '005_attract.bin' (Kapitel 7)

Die Lücken müssen aufgefüllt werden, damit jeder Block genau 16 KByte groß ist. Eine Prüfsumme gibt es nicht.

### 10.2. Spielauswahl

Das erste Image, das Sie auf die SD-Karte kopieren, wird mit Spielauswahl '0' (alle OFF) gewählt, das zweite mit '1' (alle OFF außer Dip1) und so weiter.

Da das FPGA nur feste Sektornummern liest, spielt der Dateiname keine Rolle - Sie können ihn frei wählen. Die Datei muss nur an der richtigen Stelle auf der SD-Karte liegen, und diese Stelle bestimmen Sie über die Reihenfolge, in der Sie die Dateien kopieren.

### 10.3. Beispiel Charlie's Angels

Für Charlie's Angels brauchen Sie (wie für alle anderen System1-Spiele) die beiden System-ROMs 'u5_cf.bin' und 'u4_ce.bin' und das spielspezifische ROM, hier '425.cpu'. Eine ROM-Datei für GottFA1 (charlies) mit Attract-Mode-Befehlen erzeugen Sie unter Windows mit:

copy /b u5_cf.bin + u4_ce.bin + 425.cpu + 7K + 005_attract.bin charlies

Bei einem Multisound-Spiel kommen die Sound-ROMs dazwischen, z. B. bei Totem:

copy /b u5_cf.bin + u4_ce.bin + 429.cpu + 429.snd + 6530sys1.bin + 5K + 009_attract.bin totem

Die Dateien '5K' und '7K' enthalten keine Daten und füllen nur die Lücke. Sie liegen in meinem Software-Repository auf lisy.dev.

## 11. Spiel-ROMs im FPGA-Flash

Neu mit Software x.30. Das FPGA startet aus einem Flash-Baustein (EPCS16, 2 MByte) auf der FPGA-Platine, und der Platz hinter dem FPGA-Programm reicht für die Spiel-ROMs aller 16 Spiele. Eine Platine mit ROMs im Flash läuft ohne SD-Karte.

Flash-Adresse 080000h + Spielnummer x 4000h, 16 KByte je Spiel - genau der Block der SD-Karte (Kapitel 10.1)
- Steckt eine Karte, hat die Karte immer Vorrang. So können Sie andere ROMs von einer Karte ausprobieren, ohne den Flash anzufassen.
- Fehlt die Karte oder antwortet sie nicht, liest die Platine den Flash. Spieler 3 zeigt dann READFL statt READSD (Kapitel 5.2).
- Eine Prüfsumme gibt es weder auf der Karte noch im Flash. GottFA1 prüft nur, dass der Platz des gewählten Spiels nicht leer ist; ein leerer Platz zeigt ERROR.

Die ROMs sind urheberrechtlich geschützt und können deshalb nicht Teil des Downloads von lisy.dev sein. Sie bringen sie selbst dorthin, aus Ihrem eigenen SD-Karten-Image:

1. Die ROM-Datei bauen. Im GottFA1_PLuS-Quellbaum (github.com/bontango/GottFA1_PLuS) aufrufen:

 scripts\make_flash_hex.ps1 -Image <image file> -Out variants\<variant>\output_files\gottfa1_roms.hex
  Das Skript listet jedes gefundene Spiel auf. Übernommen werden die Spiele 0 bis 15, leere Plätze werden ausgelassen.
2. Das FPGA-Programm Ihrer Platine im Ordner variants\<variant> bauen (oder die SYS1.sof eines Builds nehmen) und dort quartus_cpf -c gottfa1_roms.cof aufrufen. Das packt FPGA-Programm und ROMs in eine Datei, output_files\gottfa1_roms.jic.
3. gottfa1_roms.jic statt der normalen Datei mit dem Quartus Programmer programmieren, mit angekreuztem 'Verify' (Kapitel 9.3).

Die Variantennamen sind die des Quellbaums: hw21x_cyclone_10, hw21x_cyclone_iv_v4, hw20x_cyclone_iv_v4, hw21x_cyclone_iv_v3, hw20x_cyclone_iv_v3.

Behalten Sie diese Datei für sich. Sie enthält die Spiel-ROMs und darf nicht weitergegeben werden.

## 12. Resets mitten im Spiel

Startet Ihr Spiel während des Spielens von selbst neu, ist die Ursache fast immer eine Spule mit fehlender oder defekter Freilaufdiode. Schaltet eine solche Spule ab, schickt sie eine Spannungsspitze durch die Verkabelung des Geräts, und diese Spitze kann die Elektronik von GottFA1 erreichen.

1. Prüfen Sie die Freilaufdioden aller Spulen und Relais (Gottlieb setzt eine 1N4004 direkt an jede Spule). Das ist die eigentliche Abhilfe.
2. Verwenden Sie Software x.30 oder neuer. Bis x.03 reichte ein einziger Störimpuls von wenigen Nanosekunden auf der Leitung des Tasters 'FPGA reset', um die Platine neu zu starten. Seit x.30 muss diese Leitung 50 ms low sein.
3. Schauen Sie nach einem Neustart auf die Diagnosezähler (Kapitel 5.4). R00G00 bedeutet, dass das FPGA neu geladen wurde - dann die Versorgungsspannungen prüfen und die Spulen, die in diesem Moment geschaltet haben.
4. Bei älteren Platinen hält ein 100-nF-Kondensator, parallel zum Taster 'FPGA reset' eingelötet, Störimpulse zusätzlich von dieser Leitung fern.

Die vollständige Auswertung mit Empfehlungen für die Hardware steht im Quellbaum: docs/Stoerimpulse_Resets.md (https://github.com/bontango/GottFA1_PLuS/blob/main/docs/Stoerimpulse_Resets.md).

## Anhang A Beispiel 'Spieleliste'

Das ist die Belegung meines SD-Karten-Images (v2.00). Spiele 0 bis 8 benutzen den 3-Ton-Sound, Spiele 9 bis 15 die Multisound-Karte. Spielnamen, Kurznamen und on/off stehen unverändert wie im Original.

Nr | S1 | S2 | S3 | S4 | Kurzname | Name
0 | off | off | off | off | cleoptra | Cleopatra
1 | on | off | off | off | sinbad | Sinbad
2 | off | on | off | off | jokrpokr | Joker Poker
3 | on | on | off | off | dragon | Dragon
4 | off | off | on | off | closeenc | Close Encounters of the Third Kind
5 | on | off | on | off | charlies | Charlie's Angels
6 | off | on | on | off | solaride | Solar Ride
7 | on | on | on | off | countdwn | Count-Down
8 | off | off | off | on | pinpool | Pinball Pool
9 | on | off | off | on | totem | Totem
10 | off | on | off | on | hulk | The Incredible Hulk
11 | on | on | off | on | genie | Genie
12 | off | off | on | on | buckrgrs | Buck Rogers
13 | on | off | on | on | torch | Torch
14 | off | on | on | on | roldisco | Roller Disco
15 | on | on | on | on | astannie | Asteroid Annie and the Aliens
