bontango/GottFA1_PLuS/bin/changelog.txt

GottFA1_PLuS - ausgelieferte Programmierdateien
===============================================

Ab dem Umbau auf den gemeinsamen Sourcebaum (13.08.2026) legt scripts\release.ps1
die Artefakte nach bin\<BinFolder>\GottFA1_PLuS_v<BoardId><SW_SUB>.jic und haengt
unten an diese Datei an. Der Dateiname traegt die Version, der Ordner das Board.

Die vier Dateien, die schon vorher hier lagen, folgen einer aelteren Namensgebung
(flach in bin\, Platine statt Board im Namen). Ihre Zuordnung - nachtraeglich
bestimmt, weil sie aus dem Namen allein NICHT hervorgeht:

  GottFA1_PLuS_HW20x_v700.jic   2.097.375 B  Cyclone IV  hw20x_cyclone_iv_v4   Code 7.00
  GottFA1_PLuS_HW20x_v701.jic   2.097.375 B  Cyclone IV  hw20x_cyclone_iv_v4   Code 7.01
  GottFA1_PLuS_HW21x_v801.jic   2.097.375 B  Cyclone IV  hw21x_cyclone_iv_v4   Code 8.01
  GottFA1_PLuS_HW21x_v901.jic   2.097.377 B  Cyclone 10  hw21x_cyclone_10      Code 9.01

Der Nachweis fuer die letzte Zeile ist die Dateigroesse: 2.097.377 Byte ist
geraetetypisch fuer 10CL006Y, waehrend EP4CE6 2.097.375 Byte liefert. Das ist
wichtig, weil die Variante hw21x_cyclone_iv_v3 vor dem Umbau ebenfalls "V 901"
anzeigte, obwohl sie nur den Code-Stand 8.01 hatte - von IHR wurde nie etwas
ausgeliefert. Sie hat deshalb jetzt die Board-ID 6.

Board-IDs: 6 = HW v2.1x Cyclone IV v3 (EP4CE6F17C8, 256-FBGA)
           7 = HW v2.0x Cyclone IV v4 (EP4CE6E22C8)
           8 = HW v2.1x Cyclone IV v4 (EP4CE6E22C8)
           9 = HW v2.1x Cyclone 10    (10CL006YE144C8G)

Welches Board mit welchem Stand tatsaechlich auf Hardware lief, steht in
VARIANTEN.md - nicht hier.

2026-10-24 12:28  Version .30
  x.30: game ROMs from the configuration flash (EPCS16) when no SD card answers, no CRC; reset button filtered (50 ms), slam/outhole/reset switch filtered (1 ms); diagnostic counters R/G on the boot display. Not hardware tested.
  hw20x_cyclone_iv_v4    7.30   GottFA1_PLuS_v730.jic         2.097.375 B  sha256:100EFB2996800F17
  hw21x_cyclone_10       9.30   GottFA1_PLuS_v930.jic         2.097.377 B  sha256:ED793AEE1122F60C
  hw21x_cyclone_iv_v3    6.30   GottFA1_PLuS_v630.jic         2.097.375 B  sha256:9094A86522BAB6E8
  hw21x_cyclone_iv_v4    8.30   GottFA1_PLuS_v830.jic         2.097.375 B  sha256:BE102ACA494F3166

  Details x.30 (all boards, display V 630 / V 730 / V 830 / V 930):
  - Game ROMs from the FPGA configuration flash (EPCS16): when no SD card answers, the
    same 16 KByte per game are read from flash address 080000h + game * 4000h
    (rtl/common/Flash_ROM.vhd). No CRC check, only a check against an empty slot
    (first byte FF -> ERROR). Boot from flash shows READFL instead of READSD.
  - Reset button: has to be low for 50 ms (rtl/common/input_filter.vhd). Before, a
    single 20 ns spike on the pin restarted the board - the most likely cause of the
    "reset in the middle of a game" reports (coils without flyback diode).
  - Slam, outhole and Gottlieb reset switch: 1 ms glitch filter.
  - Diagnostic counters on the boot display, player 4: "R01G37" = resets through the
    reset button / dropped short pulses on it. Cleared only at power-up, so R00G00
    after an unexpected restart means the FPGA was reconfigured (supply dip, nCONFIG).
  - MISO with weak pull-up.
  - Background and hardware recommendations: docs/Stoerimpulse_Resets.md.
  Without game ROMs (flash fallback empty, needs an SD card as before): the four files above.
  WITH game ROMs from GottFA1_SD_Image_v200.img, games 0..15 - local use only, not on
  GitHub (copyrighted ROMs, *_roms.jic in .gitignore):
  hw20x_cyclone_iv_v4    7.30   GottFA1_PLuS_v730_roms.jic    2.097.375 B  sha256:AC908DB176281E58
  hw21x_cyclone_10       9.30   GottFA1_PLuS_v930_roms.jic    2.097.377 B  sha256:F1C923D94E986DBC
  hw21x_cyclone_iv_v3    6.30   GottFA1_PLuS_v630_roms.jic    2.097.375 B  sha256:64AAB9E1ADBA9C15
  hw21x_cyclone_iv_v4    8.30   GottFA1_PLuS_v830_roms.jic    2.097.375 B  sha256:5F10B728DDF67693

2026-10-24  7.30 (hw20x_cyclone_iv_v4) tested successfully on hardware. 9.30, 8.30 and 6.30 not hardware tested yet.

2026-10-24 16:02  Version .30
  New variant hw20x_cyclone_iv_v3: hardware v2.0x with the Cyclone IV board v3 (EP4CE6F17C8), board id 5, same x.30 code as all other boards. Pinout translated from hw20x_cyclone_iv_v4 via the header pinout of the two FPGA boards. Not hardware tested.
  hw20x_cyclone_iv_v3    5.30   GottFA1_PLuS_v530.jic         2.097.375 B  sha256:00E5430F6672877F
  WITH game ROMs from GottFA1_SD_Image_v200.img (local use only, *_roms.jic in .gitignore):
  hw20x_cyclone_iv_v3    5.30   GottFA1_PLuS_v530_roms.jic    2.097.375 B  sha256:2F1025FB83003BBF

2026-10-24  5.30 (hw20x_cyclone_iv_v3) tested successfully on hardware. Tested so far: 7.30 and 5.30; 9.30, 8.30 and 6.30 not yet.

2026-10-24 19:36  Version .30
  Erstes Release fuer das Cyclone-IV-Board v7 (V 430): FA-Control ueber den ESP32-C3 auf X7, PPS4-RAM im M9K. Auf v7 getestet: Boot von SD und ohne SD (READFL, ROMs ueber WLAN geschrieben), FA-Control-Connect, Displays. Lampen/Spulen/Schalter/Sound unter FA-Control ungetestet.
  hw20x_cyclone_iv_v7    4.30   GottFA1_PLuS_v430.jic         2.097.375 B  sha256:A49B70F74B3BA1B9
  hw20x_cyclone_iv_v7    4.30   GottFA1_PLuS_v430.rbf           156.068 B  sha256:D2BC38AF069F81F9

2026-10-24 19:42  Version .30
  Ersetzt den Eintrag 19:36: Board v7 hat keinen JTAG-Stecker, programmiert wird nur ueber den ESP32 - Release ist die .rbf (WRITE) plus _roms.bin (WRITE GAME ROMS, 0x080000, nur lokal). Inhalt unveraendert: FA-Control, PPS4-RAM im M9K; getestet Boot von SD und ohne SD (READFL), FA-Control-Connect, Displays.
  hw20x_cyclone_iv_v7    4.30   GottFA1_PLuS_v430.rbf           156.068 B  sha256:D2BC38AF069F81F9
  hw20x_cyclone_iv_v7    4.30   GottFA1_PLuS_v430_roms.bin      262.144 B  sha256:EF61146D47E2F1AA

2026-10-25 18:42  Version .31
  Monitor fuer FA_Control (Opcode 0x6E, FA_Control ab 1.25): Lampen, Spulen und Tonleitungen mit Merkbits, Schalter und Displays ohne Uebernahme lesbar. Nur v7 released, die anderen Boards bleiben bei .30 (fuer sie aendert sich funktional nichts). Auf v7 getestet: Monitor-Modus mit laufendem Spiel (Displays, Lampen, Spulen, Chimes, Schalter), Wechsel Control/Monitor.
  hw20x_cyclone_iv_v7    4.31   GottFA1_PLuS_v431.rbf           160.504 B  sha256:98AC8E324324224D
  hw20x_cyclone_iv_v7    4.31   GottFA1_PLuS_v431_roms.bin      262.144 B  sha256:EF61146D47E2F1AA
