bontango/GottFA1_PLuS/rtl/common/SD_Card.vhd

--
-- SD_Card.vhd
-- read SD card in 'raw' Mode to move code to RAM/ROM
-- version with reset_l and 16KByte
-- for GottFA
-- bontango 10.2020
--
-- v01 added feedback on successfull SD card read
-- v02 synchronous reset
-- v03 extended CMD to 14 bytes, added second R1 position (needed for some cards), added error state
-- v04 new output o_no_card: '1' while the read has ended in the error state, i.e. no card
--     answered or its init failed (every error of this loader is an init error, there is
--     no CRC check). Starts the flash fallback (Flash_ROM.vhd). 10.2026

library IEEE;
use IEEE.std_logic_1164.all;
--use IEEE.std_logic_arith.all;
--use IEEE.std_logic_unsigned.all;
use IEEE.numeric_std.all;

	entity SD_Card is
		port(
		i_Clk		: IN STD_LOGIC  := '1';
		-- Control/Data Signals,
		i_Rst_L : in std_logic;     -- FPGA Reset		
		-- PMOD SPI Interface
		o_SPI_Clk  : out std_logic;
		i_SPI_MISO : in std_logic;
		o_SPI_MOSI : out std_logic;
		o_SPI_CS_n : out std_logic;
		-- selektion
		selection : in std_logic_vector(7 downto 0);
		-- sd card
		address_sd_card	: buffer  std_logic_vector(13 downto 0);
		data_sd_card	: out std_logic_vector(7 downto 0);
		wr_rom :  out std_logic;		
		-- start CPU
		cpu_reset_l : out STD_LOGIC;
		-- feedback
		SDcard_error : out STD_LOGIC;
		-- '1' = no usable card, see v04. Stays '1', the error state is final.
		o_no_card : out STD_LOGIC
		);
    end SD_Card;
	 
   architecture Behavioral of SD_Card is		
		type STATE_T is ( Startdelay, send_read_request, wait_for_read, continue, 
								initiate_read_sector, wait_for_begin_of_data,check_for_FE_flag, sector_read, wait_for_byte_read,
								check_sector_byte, inc_addr_and_unset_wr, stop_read, delay_and_repeat, all_done, error );
		signal state_A : STATE_T;       
		
		
		-- SPI stuff for SD card commands	
		signal TX_Data_A : std_LOGIC_VECTOR ( 111 downto 0); -- 14 Bytes ( 6 cmd bytes, 1 NCR ,1 Return ,4 CMD Echo )
		signal RX_Data_A : std_LOGIC_VECTOR ( 111 downto 0);  -- we also send 0xFF with CS disable before and after
		signal TX_Start_A : std_LOGIC;
		signal TX_Done_A : std_LOGIC;
		signal MOSI_A : std_LOGIC;
		signal SS_A :  std_LOGIC;
		signal SPI_Clk_A :  std_LOGIC;

		-- SPI stuff for SD card read, byte by byte
		signal TX_Data_R : std_LOGIC_VECTOR ( 7 downto 0); 
		signal RX_Data_R : std_LOGIC_VECTOR ( 7 downto 0);
		signal TX_Start_R : std_LOGIC;
		signal TX_Done_R : std_LOGIC;
		signal MOSI_R : std_LOGIC;
		signal SS_R :  std_LOGIC;
		signal SPI_Clk_R :  std_LOGIC;
		
		-----		
		signal cmd_count : integer range 0 to 16; 
		signal R1_response : std_LOGIC_VECTOR (7 downto 0);		
		signal R1_response_2 : std_LOGIC_VECTOR (7 downto 0);		
		signal Echo_response : std_LOGIC_VECTOR (7 downto 0);		
		signal active_master : std_LOGIC_VECTOR (1 downto 0) := "00";
		signal do_not_disable_SS : std_LOGIC;		
		signal sector : unsigned (15 downto 0);	
		
		signal byte_count : integer range 0 to 520; 		
		
		signal attempts : integer range 0 to 5000; 
		signal counter  : integer range 0 to 5000000;   -- delay, for 10ms use 500.000
	begin		
		
		-- signals for the two SPI Master
	o_SPI_MOSI <=	
	MOSI_A when active_master = "01" else
	MOSI_R when active_master = "10" else
	'0';

	o_SPI_Clk <=
	SPI_Clk_A when active_master = "01"  else
	SPI_Clk_R when active_master = "10"  else
	'0';

	o_SPI_CS_n <=
	SS_A when active_master = "01"  else
	'0' when active_master = "10" else
	'1';

	-- see v04
	o_no_card <= '1' when state_A = error else '0';
	
	
SD_CARD_ACCESS: entity work.SPI_Master
    generic map (      
      Laenge => 112,
		SPI_Taktfrequenz => 400000) -- 400KHz for commands
    port map (
			  TX_Data  => TX_Data_A,
           RX_Data  => RX_Data_A,
           MOSI     => MOSI_A,
           MISO     => i_SPI_MISO,
           SCLK     => SPI_Clk_A,
           SS       => SS_A,
           TX_Start => TX_Start_A,
           TX_Done  => TX_Done_A,
           clk      => i_Clk,	  
			  do_not_disable_SS => do_not_disable_SS,
			  do_not_enable_SS => '0'
      );
		
SD_CARD_READ: entity work.SPI_Master --read i byte by byte (slooow)
    generic map (      
      Laenge => 8,
		SPI_Taktfrequenz => 400000) -- 400KHz for commands
    port map (
			  TX_Data  => TX_Data_R,
           RX_Data  => RX_Data_R,
           MOSI     => MOSI_R,
           MISO     => i_SPI_MISO,
           SCLK     => SPI_Clk_R,
           SS       => SS_R,
           TX_Start => TX_Start_R,
           TX_Done  => TX_Done_R,
           clk      => i_Clk,
			  do_not_disable_SS => do_not_disable_SS,
			  do_not_enable_SS => '0'
      );

		
		SD_Card: process (i_Clk, i_Rst_L )
			--constant all_high : std_LOGIC_VECTOR (47 downto 0) := x"FFFFFFFFFFFF";
			constant CMD0 : std_LOGIC_VECTOR (47 downto 0) := x"400000000095"; --reset			
			constant CMD8 : std_LOGIC_VECTOR (47 downto 0) := x"48000001AA87"; --check the version of SD card					
			--constant CMD1 : std_LOGIC_VECTOR (47 downto 0) := x"4100000000F9"; -- initiate the initialization process (old cards)
			--only support for 'new' Sd cards at the moment
			constant CMD55 : std_LOGIC_VECTOR (47 downto 0) := x"7700000000FF";	-- leading cmd for AMD commands 
			constant ACMD41 : std_LOGIC_VECTOR (47 downto 0) := x"6940000000FF";	-- initiate the initialization process			
			constant CMD17 : std_LOGIC_VECTOR (47 downto 0) := x"5100000000FF"; --single-read block
			constant CMD18 : std_LOGIC_VECTOR (47 downto 0) := x"5200000000FF"; --multi-read block
			constant CMD12 : std_LOGIC_VECTOR (47 downto 0) := x"4C00000000FF"; --stop to read data
			constant CMD58 : std_LOGIC_VECTOR (47 downto 0) := x"7A00000000FF"; --read OCR
			
		begin
		if rising_edge(i_Clk) then
			if i_Rst_L = '0' then --Reset condidition (reset_l)    
				cpu_reset_l <= '0';
				TX_Start_A <= '0';		
				TX_Start_R <= '0';		
				TX_Data_R <= x"FF";				
				cmd_count <= 0;
				active_master <= "00";
				do_not_disable_SS <= '0'; --default
				wr_rom <= '0';
				address_sd_card <= (others => '0');
				byte_count <= 0;
				SDcard_error <= '1'; -- active low
				counter <= 0;
				attempts <= 0;
				state_A <= Startdelay;    
			else			
				case state_A is
				-- STATE MASCHINE ----------------
				 when Startdelay => 
						active_master <= "01";			
					--give SD card time to power up					
					counter <= counter +1;					
					if ( counter = 5000000 ) then --100ms 
						state_A <= send_read_request;
						counter <= 0;						
					end if;																													
				when send_read_request =>						
				   case cmd_count is
						when 1 => TX_Data_A <= x"FF" & CMD0 & x"FFFFFFFFFFFFFF"; --go idle state, resets SD card
						when 2 => TX_Data_A <= x"FF" & CMD8 & x"FFFFFFFFFFFFFF";	-- send interface condition
						when 3 => TX_Data_A <= x"FF" & CMD55 & x"FFFFFFFFFFFFFF";						
						when 4 => TX_Data_A <= x"FF" & ACMD41 & x"FFFFFFFFFFFFFF";		
						when 5 => TX_Data_A <= x"FF" & CMD58 & x"FFFFFFFFFFFFFF";		
						when 6 => TX_Data_A <= x"FF" & CMD18 & x"FFFFFFFFFFFFFF";	
									 do_not_disable_SS <= '1';
									 -- special: calculate sector on GottFA80 SD
									 -- where to read rom dependign on dip switch
									 -- first rom starts at sector 660
									 -- we have 16KByte of data
									 -- which is 32 sectors 512Byte each
									 --TX_Data_A(71 downto 56)  <= "0000" & std_logic_vector (unsigned(selection) *32 + 660);
									 TX_Data_A(79 downto 64)  <= std_logic_vector (unsigned(selection) *32 + 660);
									 --TX_Data_A(71 downto 56)  <= x"0296"; --sector 662 with data
						when 7 => TX_Data_A <= x"FF" & CMD12 & x"FFFFFFFFFFFFFF";	
									 do_not_disable_SS <= '0';	
						when others => TX_Data_A <= x"FF" & x"FFFFFFFFFFFF" & x"FFFFFFFFFFFFFF"; -- init and read
					end case;
					TX_Start_A <= '1'; -- set flag for sending byte		
					state_A <= wait_for_read;					
										
				when wait_for_read =>					
						if (TX_Done_A = '1') then -- Master sets TX_Done when TX is done ;-)
							TX_Start_A <= '0'; -- reset flag 		
								-- we assume R1 Response is at fix postion ( 1 Byte nCR, then R1)
								-- some cards have it one position later so lets try this also
								R1_response <= RX_Data_A( 47 downto 40);								
								R1_response_2 <= RX_Data_A( 39 downto 32);	--sometimes R1 response comes late							
								Echo_response <= RX_Data_A( 15 downto 8);
								data_sd_card <= RX_Data_A( 47 downto 40);								
							state_A <= continue;							
						end if;
										
				when continue =>		
					if (TX_Done_A = '0') then -- Master sets back TX_Done when ready again				
								cmd_count <= cmd_count +1;
								case cmd_count is
									when 1 => --check response of CMD0
										if ( R1_response /= x"01") then
											if (attempts < 8) then
												cmd_count <= 1; --repeat
												attempts <= attempts +1;
												state_A <= send_read_request; 
											else
												state_A <= error;
											end if;	
										else --success
											attempts <= 0;
											state_A <= send_read_request; -- next cmd to send																																						
										end if;																		
									when 2 => --check response of CMD8
										if ( ( R1_response /= x"01") or (Echo_response /= x"AA")) then
											state_A <= error;
										else
											state_A <= send_read_request; -- next cmd to send																											
										end if;
									when 4 => -- count 4 is SD card init--repeat CMD55 & ACMD41 until card is READY
										if (( R1_response /= x"00") and ( R1_response_2 /= x"00")) then 										
											if (attempts < 5000) then
												cmd_count <= 3; --repeat go back to init
												attempts <= attempts +1;
												state_A <= delay_and_repeat; 
											else
												state_A <= error;
											end if;	
										else --success
											attempts <= 0;
											state_A <= send_read_request; -- next cmd to send																																						
										end if;													
									when 6 => --last command send, we now read data
										cmd_count <= 0;	
										TX_Data_R <= x"FF";
										active_master <= "10";		
										address_sd_card <= (others => '0');			
										byte_count <= 0;							
										state_A <= initiate_read_sector;
									when 7 => -- we send CMD12 to stop read sector, all done
										wr_rom <= '0';		
										-- start cpu
										cpu_reset_l <= '1';						
										state_A <= all_done;																
										
									when others =>
										state_A <= send_read_request; -- next cmd to send																											
								end case;
					end if;
					
				when delay_and_repeat =>	
					counter <= counter +1;					
					if ( counter = 500000 ) then --10ms 
						state_A <= send_read_request;
						counter <= 0;						
					end if;											
		--------------------------------------
		-- second master  --------------------
		-- read 16 sectors -------------------
		--------------------------------------
		
				when initiate_read_sector =>				
							TX_Start_R <= '1'; -- set flag for sending byte												
							state_A <= wait_for_begin_of_data;					
							
				when wait_for_begin_of_data =>
							if (TX_Done_R = '1') then -- Master sets TX_Done when TX is done ;-)
							TX_Start_R <= '0'; -- reset flag 		
							state_A <= check_for_FE_flag;
						end if;
						
				when check_for_FE_flag =>							
						if (TX_Done_R = '0') then -- Master sets back TX_Done when ready again						
						data_sd_card <= RX_Data_R;
						   if RX_Data_R = x"FE" then							
								state_A <= sector_read; --flag found, next byte is data
							else
								state_A <= initiate_read_sector; --next byte to read and check
							end if;							
						end if;
	
				when sector_read =>
							TX_Start_R <= '1'; -- set flag for sending byte		
							wr_rom <= '0'; --stop writing to ram/rom
							state_A <= wait_for_byte_read;					
							
				when wait_for_byte_read =>
							if (TX_Done_R = '1') then -- Master sets TX_Done when TX is done ;-)							
									TX_Start_R <= '0'; -- reset flag 	
									-- count byte
									byte_count <= byte_count +1;		
									--assign data
									data_sd_card <= RX_Data_R;											
									state_A <= check_sector_byte;
							end if;
							
				when check_sector_byte =>							
						if (TX_Done_R = '0') then -- Master sets back TX_Done when ready again
							-- where are we in sector read?
							if byte_count <= 512 then	-- in sector read
								wr_rom <= '1';	-- write to ram/rom with current data & address
								state_A <= inc_addr_and_unset_wr;		-- write to ram/rom
							elsif byte_count <= 514 then -- in crc read
								-- no write for crc
								state_A <= sector_read;		-- next byte						
							else -- sector read finished
								byte_count <= 0;
								state_A <= initiate_read_sector;		-- next sector					
							end if;																											
						end if;
						
				when inc_addr_and_unset_wr =>		
								wr_rom <= '0';	
								-- prepare address for next
								address_sd_card <= std_LOGIC_VECTOR(unsigned(address_sd_card) +1);
								-- finished?								
								if unsigned(address_sd_card) = "11111111111111" then 										
										state_A <= stop_read;		--just read last byte
								else
										state_A <= sector_read;		-- next byte						
								end if;
												
				when stop_read =>																
								cmd_count <= 7; --we use cmd counter from init routine								
								active_master <= "01"; --because sending of a command								
								state_A <= send_read_request; 
								
				when all_done =>		
					SDcard_error <= '1'; --active low
				when error =>		
					SDcard_error <= '0'; --active low
				end case;	
			end if; --rst 
		end if; --rising edge					
	end process;
				
					
    end Behavioral;				
