bontango/GottFA1_PLuS/(commit log)

2026-06-30 Initial commit: GottFA1_PLuS HW v2.1x / Cyclone 10 (10CL006YE144C8G)
    VHDL Quartus 22.1 project emulating the Gottlieb System 1 pinball MPU
    on the GottFA1_PLuS DIY board (hardware v2.1x, Intel Cyclone 10 LP).
    Includes the SYS1 Quartus project plus the shared (lib_common) and
    Cyclone-10-specific (lib_cyclone_10) VHDL libraries. SYS1.vhd v9.03.
2026-06-30 docs: add GottFA1_PLuS hardware reference (HW v2.1x / Cyclone 10)
    Comprehensive English hardware description of the GottFA1_PLuS board as
    seen from the SYS1 FPGA design: overview/emulated chipset, HW versions,
    power supply, FPGA I/O & level shifting, displays, switch matrix, lamps,
    solenoids, sound, DIP switches, storage, LEDs, full FPGA pin map (from
    SYS1.qsf), connectors and references. Intended as the basis for a
    built-in hardware test routine. Whitelists docs/ in .gitignore.
2026-06-30 docs: correct 42 V/60 V rail usage (Gottlieb displays, not solenoids)
    The 42 V / 60 V rails feed the gas-discharge displays (42 V status /
    credit display, 60 V the four player score displays), not the solenoid
    or lamp coils. Solenoids and lamps are switched low-side via N-channel
    MOSFETs to GND. Updated the safety note, block diagram, power, I/O,
    display, lamp, solenoid and connector sections accordingly.
2026-08-13 Umbau auf einen gemeinsamen Sourcebaum fuer alle vier Boardvarianten
    Bisher lagen hier vier vollstaendige Quartus-Projektordner desselben Designs
    nebeneinander, jeder mit eigener SYS1.qsf und eigener Kopie von SYS1.vhd. Der
    Schaden war messbar, nicht theoretisch:
    - Die Aenderung v9.03 (Testtaster-Verdrahtung) wurde nie in die drei anderen
    Kopien nachgezogen - drei Zeilen, jahrelang.
    - CycloneIV_v3 zeigte "V 901", hatte aber nur den Code-Stand 8.01 und kollidierte
    damit mit dem ausgelieferten Cyclone-10-Build. Dass die 901 dem Cyclone 10
    gehoert, ist an der .jic-Groesse nachweisbar (2.097.377 B ist geraetetypisch fuer
    10CL006Y; EP4CE6 liefert 2.097.375 B).
    - Beide CycloneIV-.qsf list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
2026-10-24 Release x.30: game ROMs from the configuration flash, reset filter, diagnostic counters
    - rtl/common/Flash_ROM.vhd (port of WillFA7 Flash_ROM): when no SD card answers
    (SD_Card v04, new output o_no_card) the same 16 KByte per game are read from the
    EPCS16 at 080000h + game * 4000h. No CRC, only a check against an empty slot.
    Flash pins in pins.tcl, released as regular I/O in common_header.tcl, MISO pull-up.
    - rtl/common/input_filter.vhd: reset_sw has to be low for 50 ms (was: one 20 ns
    sample restarted the board), slam/outhole/sw_reset 1 ms.
    - Diagnostic counters R/G on the boot display (player 4), cleared only at power-up.
    - scripts/make_flash_hex.ps1 and variants/*/gottfa1_roms.cof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
2026-10-24 User manuals as HTML in en/de/fr for GitHub Pages, updated to x.30
    Built from doc/GottFA1_PLuS_user manual_v1.00.docx (software 7.00) and brought up
    to x.30: flash fallback, reset filter, diagnostic counters, board variants and
    release files, Quartus Prime programmer, SD slot layout incl. Multisound roms.
    docs/index.html is the landing page, README links the online manuals.
2026-10-24 7.30 tested successfully on hardware (hw20x_cyclone_iv_v4)
    Test status updated in the user manuals (en/de/fr), changelog, baseline notes
    and docs/Stoerimpulse_Resets.md. 9.30, 8.30 and 6.30 are still untested.
2026-10-24 New variant hw20x_cyclone_iv_v3 (HW v2.0x, Cyclone IV board v3), release 5.30
    Board id 5, display V 530, same x.30 code as every other board. pins.tcl is
    hw20x_cyclone_iv_v4 translated from the E22 to the F17 board via the header
    pinout in Altera_dev_board\pins_Cyclone_II_IV_10.xlsx; that table matches all 84
    pins hw21x_cyclone_iv_v4 and hw21x_cyclone_iv_v3 share. LED_Test, USB_Rx, USB_Tx
    and SB_Test sit on F17 pins no variant used before.
    Fit: Comb 5127, Reg 2906, Mem 88064, 92 pins, setup slack 6.954 ns, warnings as
    all other boards. bin/HW20x_CycloneIV_v3/GottFA1_PLuS_v530.jic (the _roms.jic
    stays local). Manuals, README and baseline updated. Not hardware tested.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
2026-10-24 5.30 tested successfully on hardware (hw20x_cyclone_iv_v3)
    Test status updated in the user manuals (en/de/fr), changelog, baseline notes and
    docs/Stoerimpulse_Resets.md. Tested so far: 7.30 and 5.30.
2026-10-24 Move the PPS4 internal RAM into a M9K block
    The 256x4 RAM of the PPS-4/2 core was read asynchronously, so Quartus could
    not infer a RAM (Info 276007) and built it from 1024 registers plus a 256:1
    read mux. It is now an altsyncram clocked by clk_50: address B and m_SAG are
    CPU registers, the read data settles two fast clocks after each 400 kHz CPU
    edge, writes are registered at the CPU edge.
    All five variants: Comb -963..-981, Reg -1007, Mem +1024, warning
    fingerprint unchanged, worst hold slack 0.135 ns. LE usage drops from ~88 %
    to ~71 %, which leaves room for FA-Control. hw20x_cyclone_iv_v3 briefly
    tested on hardware (v7 board, written over the ESP32): runs as before.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
2026-10-24 New variant hw20x_cyclone_iv_v7 with FA-Control
    The Cyclone IV board v7 is v3 without CH340, USB socket and JTAG header,
    with an ESP32-C3 Supermini on X7 instead. It runs FA_Control, which writes
    the EPCS over Wi-Fi and is the LISY master for rtl/fa_control (copied from
    SternFA).
    - variant_pkg: HAS_ESP32, true only for hw20x_cyclone_iv_v7 (board ID 4,
    "V 430"). gen_fa_control / gen_no_fa_control in the top level; without
    the ESP fa_active is the constant '0' and the netlist of the five other
    variants is unchanged (check.ps1: "=", warning fingerprint included).
    FA_RXD/FA_TXD/FA_CTRL_REQ are VIRTUAL_PIN there.
    - v7 pins: FA_RXD R3, FA_TXD T2 (the former CH340 lines), FA_CTRL_REQ N3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
2026-10-24 v7: generate the .rbf for the ESP32 and ship it with release.ps1
    device.tcl of hw20x_cyclone_iv_v7 sets GENERATE_RBF_FILE; variant.psd1 gets
    an optional ExtraArtifacts list ('rbf'). build.ps1 checks that every extra
    artifact exists and is newer than the compile it just ran, so a stale .rbf
    cannot slip into a release. release.ps1 copies the extras next to the main
    artifact (same name, other extension, same overwrite guard), checks all
    files before copying any, and logs them in the changelog; the device size
    check now looks at the .jic/.sof only.
    The assembler writes the .rbf compressed (156 kB instead of 368 kB). Written
    over the ESP on 24.10.2026: boots, FA-Control connects. The netlist doe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
2026-10-24 make_flash_hex.ps1 -Bin: the ROM area as raw binary for the ESP32
    Writes flash 0x080000..0x0BFFFF (all 16 slots, empty ones FF as erased) to a
    file that FA_Control on board v7 writes into the EPCS at 0x080000, without
    bit reversal. -Out (Intel HEX for the _roms.jic) is unchanged and byte-equal
    to before; at least one of -Out/-Bin. *_roms.bin is ignored like *_roms.jic.
2026-10-24 v7: boot without SD card from ROMs written over the ESP32 tested (READFL)
2026-10-24 Release 4.30 for the Cyclone IV board v7 (hw20x_cyclone_iv_v7), .jic and .rbf
2026-10-24 v7 releases a .rbf instead of a .jic; release.ps1 -RomImage
    Board v7 has no JTAG header; it is programmed through the ESP32 only. Its
    ReleaseArtifact is now 'rbf' (no quartus_cpf, no .jic); build.ps1 checks a
    .rbf main artifact like an extra one.
    release.ps1 -RomImage <sd image> adds the ROM file per board: _roms.jic for
    the boards with a .jic, _roms.bin (raw ROM area, written by the ESP32 at
    0x080000) for v7. Both stay local (.gitignore); the changelog gets name,
    size and hash only.
    Re-released 4.30 for v7: .rbf hash-identical to 19:36, plus _roms.bin.
2026-10-24 v7: remove the .jic of the first 4.30 release - board v7 has no JTAG header
2026-10-25 v7: monitor snapshot (opcode 0x6E) for FA_Control's MONITOR MODE
    FA_Control can now watch a running game without taking control: no
    CTRL_REQ, no 0x64, no watchdog, the game is not reset. Opcode 110 returns
    a length byte followed by a snapshot of 33 bytes on GottFA1: flags, lamps,
    coils now and sticky, sound sticky (10/100/1000), switches and the display
    digits as BCD nibbles.
    - fa_control.vhd: generic MON_BYTES (default 0 = answer 0x00 as for an
    unknown opcode, i.e. unchanged behaviour), port mon_data, and
    mon_rd/mon_idx per byte sent so the top level can clear sticky bits
    exactly when they leave.
    - r10788.vhd v0.9: register file exposed as regs_o (unused and optimised
    away in the o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
2026-10-25 Release 4.31 for the Cyclone IV board v7: monitor snapshot for FA_Control
    SW_SUB 30 -> 31. Only hw20x_cyclone_iv_v7 is released; for the other
    boards nothing changes functionally, they stay at .30 until their next
    release. The .rbf goes over FA_Control tile 09 (REVERSE BITS on); the
    _roms.bin was built as well but stays local (.gitignore).
    Tested on v7 with the same code (display still V 430): monitor mode with
    a running game, displays, lamps, coils, chimes and switches correct,
    switching between control and monitor mode.
